jeanthom/Otter-Iron-PRO/v2.1/Bottom/USB Type C Port (SMD Type).STEP

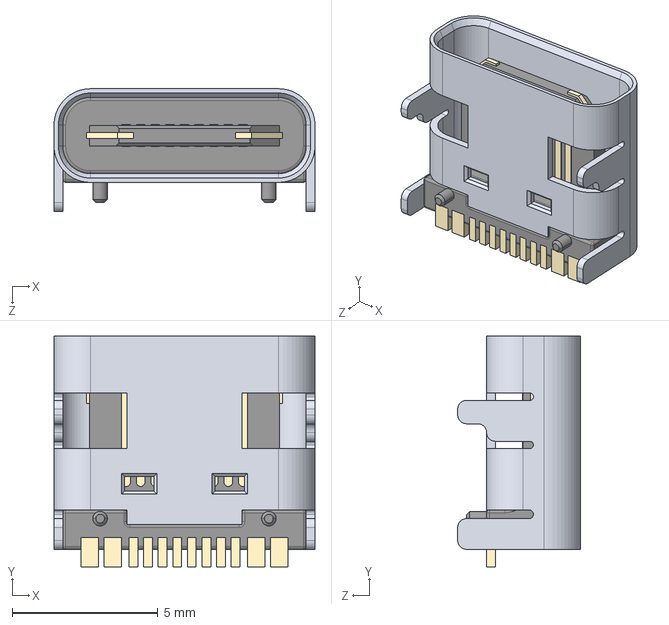
[picture p1: CAD file, 2025-04-08]
v2.1/Bottom/USB Type C Port (SMD Type).STEP
8.94 x 7.90 x 4.20 mm
