jeanthom/Otter-Iron-PRO/v2.1/C245/RPC1-12RB-6P.stp

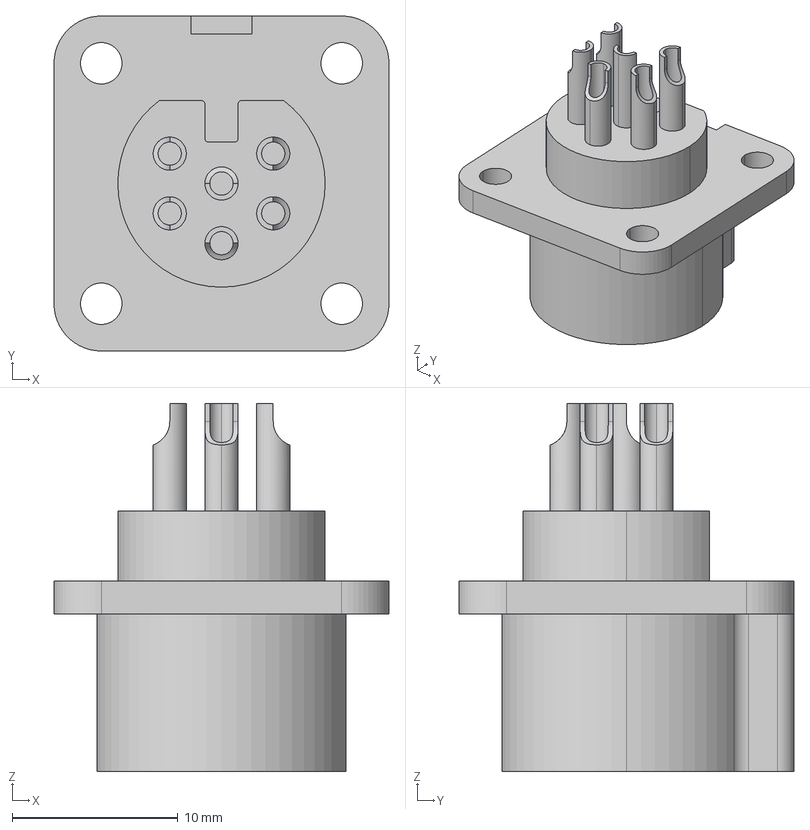
[picture p2: CAD file, 2025-04-08]
v2.1/C245/RPC1-12RB-6P.stp
20.2 x 20.2 x 22.2 mm
