jeanthom/Otter-Iron-PRO/v2.1/Stackup.FCStd

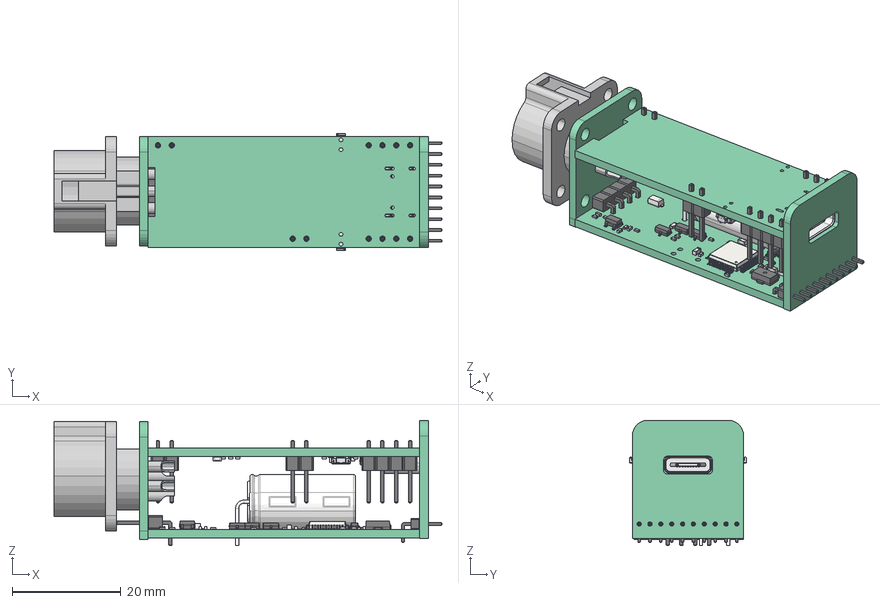
[picture p3: CAD file, 2025-04-08]
v2.1/Stackup.FCStd
71.4 x 21.6 x 23.1 mm
Pcb_2461
J6_PinHeader_1x04_P254mm_Vertical_5E93BB02
J5_PinHeader_1x04_P254mm_Vertical_5E93BAEA
J4_PinHeader_1x02_P254mm_Vertical_5E93BAD2
J3_PinHeader_1x02_P254mm_Vertical_5E93BABC
R10_R_0603_1608Metric_5E93AD9D
R24_R_0603_1608Metric_5E93ADFF
R23_R_0603_1608Metric_5E93ADF8
R13_R_0603_1608Metric_5E93ADB2
R11_R_0603_1608Metric_5E93ADA4
R7_R_0603_1608Metric_5E93AD88
C21_C_0603_1608Metric_5E93BA3C
C20_C_0603_1608Metric_5E93ABF7
C19_C_0603_1608Metric_5E93ABF0
C15_C_0603_1608Metric_5E93ABD4
C14_C_0603_1608Metric_5E93ABCD
C13_C_0603_1608Metric_5E93ABC6
C12_C_0603_1608Metric_5E93ABBF
U3_QFN_24_1EP_4x4mm_P05mm_EP27x27mm_5E93AEA4
U1_SOT_23_6_5E93AE5A
SW2_User Library-EVQP7-JA-01P_5E93AE44
SW1_User Library-EVQP7-JA-01P_5E93AE25
J1_USB Type C Port (SMD Type)_5E93AC6F
Pcb_9526
J1_PinHeader_1x10_P200mm_Horizontal_5E95C6C6
U4_LQFP_48_7x7mm_P05mm_5E93AEFF
J3_PinHeader_1x04_P254mm_Horizontal_5E93ACCE
U7_SOT_23_5_5E93AF3E
U6_SOT_23_5E93AF29
U5_SOT_23_5_5E93AF14
U2_SOT_89_3_5E93AE72
R25_R_0402_1005Metric_5E93AE06
R22_R_0805_2012Metric_5E93ADF1
R21_R_0402_1005Metric_5E93ADEA
R20_R_0402_1005Metric_5E93ADE3
R19_R_0603_1608Metric_5E93ADDC
R18_R_0402_1005Metric_5E93ADD5
R17_R_0402_1005Metric_5E93ADCE
R16_R_0402_1005Metric_5E93ADC7
R15_R_0402_1005Metric_5E93ADC0
R14_R_0402_1005Metric_5E93ADB9
R12_R_0402_1005Metric_5E93ADAB
R9_R_0402_1005Metric_5E93AD96
R8_R_0402_1005Metric_5E93AD8F
R6_R_0402_1005Metric_5E93AD81
R5_R_0402_1005Metric_5E93AD7A
R2_R_0402_1005Metric_5E93AD65
R1_R_0402_1005Metric_5E93AD5E
Q4_SOT_23_5E93AD57
Q3_SOT_23_5E93AD42
Q1_SOT_23_5E93AD14
D3_D_SOD_123F_5E93AC4E
C24_capacitor_bertical_mount_5E93AC35
C22_C_0402_1005Metric_5E93AC05
C18_C_0402_1005Metric_5E93ABE9
C17_C_0402_1005Metric_5E93ABE2
C16_C_0402_1005Metric_5E93ABDB
C11_C_0603_1608Metric_5E93ABB8
C10_C_0402_1005Metric_5E93ABB1
C9_C_0603_1608Metric_5E93ABAA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
