jeanthom/Otter-Iron-PRO/v2.1/Bottom/User Library-EVQP7-JA-01P.step

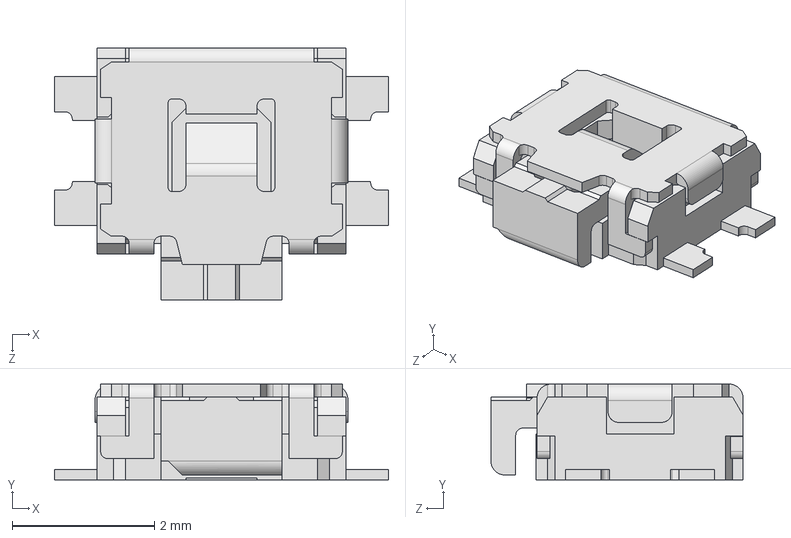
[picture p4: CAD file, 2025-04-08]
v2.1/Bottom/User Library-EVQP7-JA-01P.step
4.70 x 1.35 x 3.55 mm
