jeanthom/Otter-Iron-PRO/v2.1/Bottom/cap_el_horizontal_d10_h20_p5_w0.6.stp

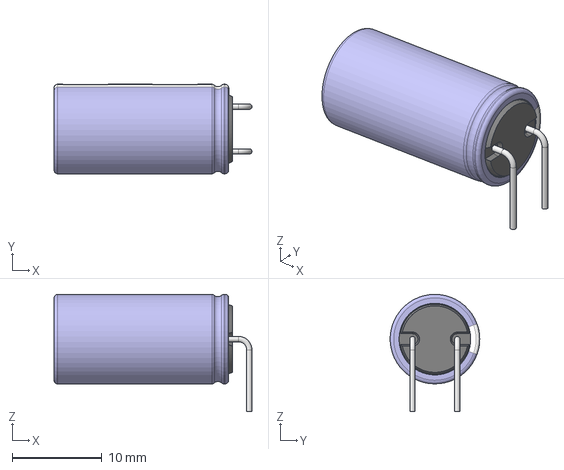
[picture p5: CAD file, 2025-04-08]
v2.1/Bottom/cap_el_horizontal_d10_h20_p5_w0.6.stp
22.1 x 10.0 x 13.1 mm
