jeanthom/Otter-Iron-PRO/v2.1/Bottom/vls6045ex.step

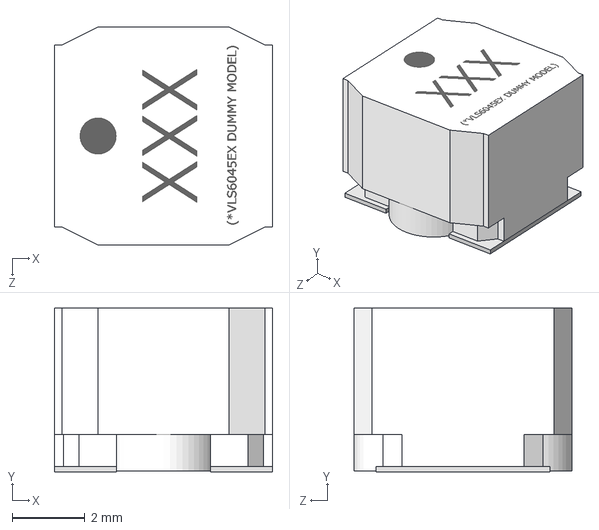
[picture p6: CAD file, 2025-04-08]
v2.1/Bottom/vls6045ex.step
6.00 x 4.50 x 6.00 mm
VLS6045EX_C(3Dmodel)
VLS6045EX_T(3Dmodel)
