jeanthom/Otter-Iron-PRO/v2.1/Bottom/Diodes_-_DMP3017SFG-7.step

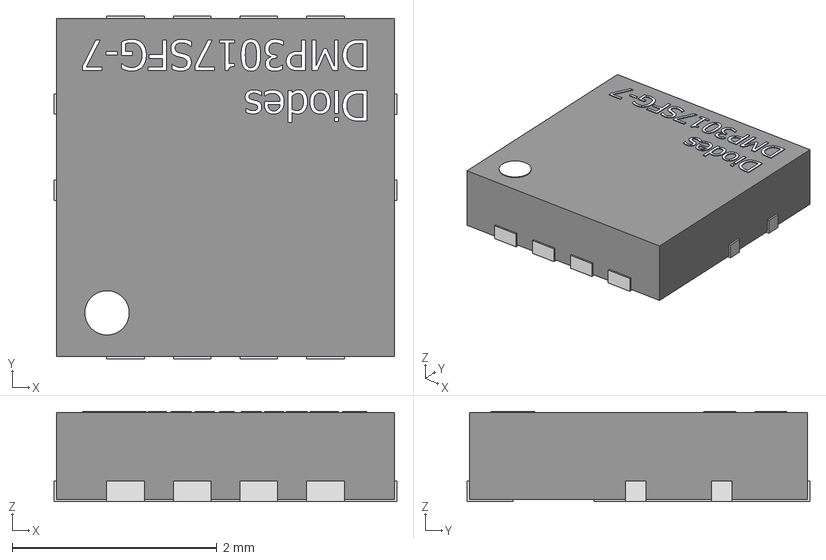
[picture p7: CAD file, 2025-04-08]
v2.1/Bottom/Diodes_-_DMP3017SFG-7.step
3.35 x 3.35 x 0.88 mm
