jeanthom/Otter-Iron-PRO/v2.1/Top/OtterIron_PRO_Top.kicad_pcb

## KiCad design v2.1/Top/OtterIron_PRO_Top.kicad_pcb (2025-04-08)

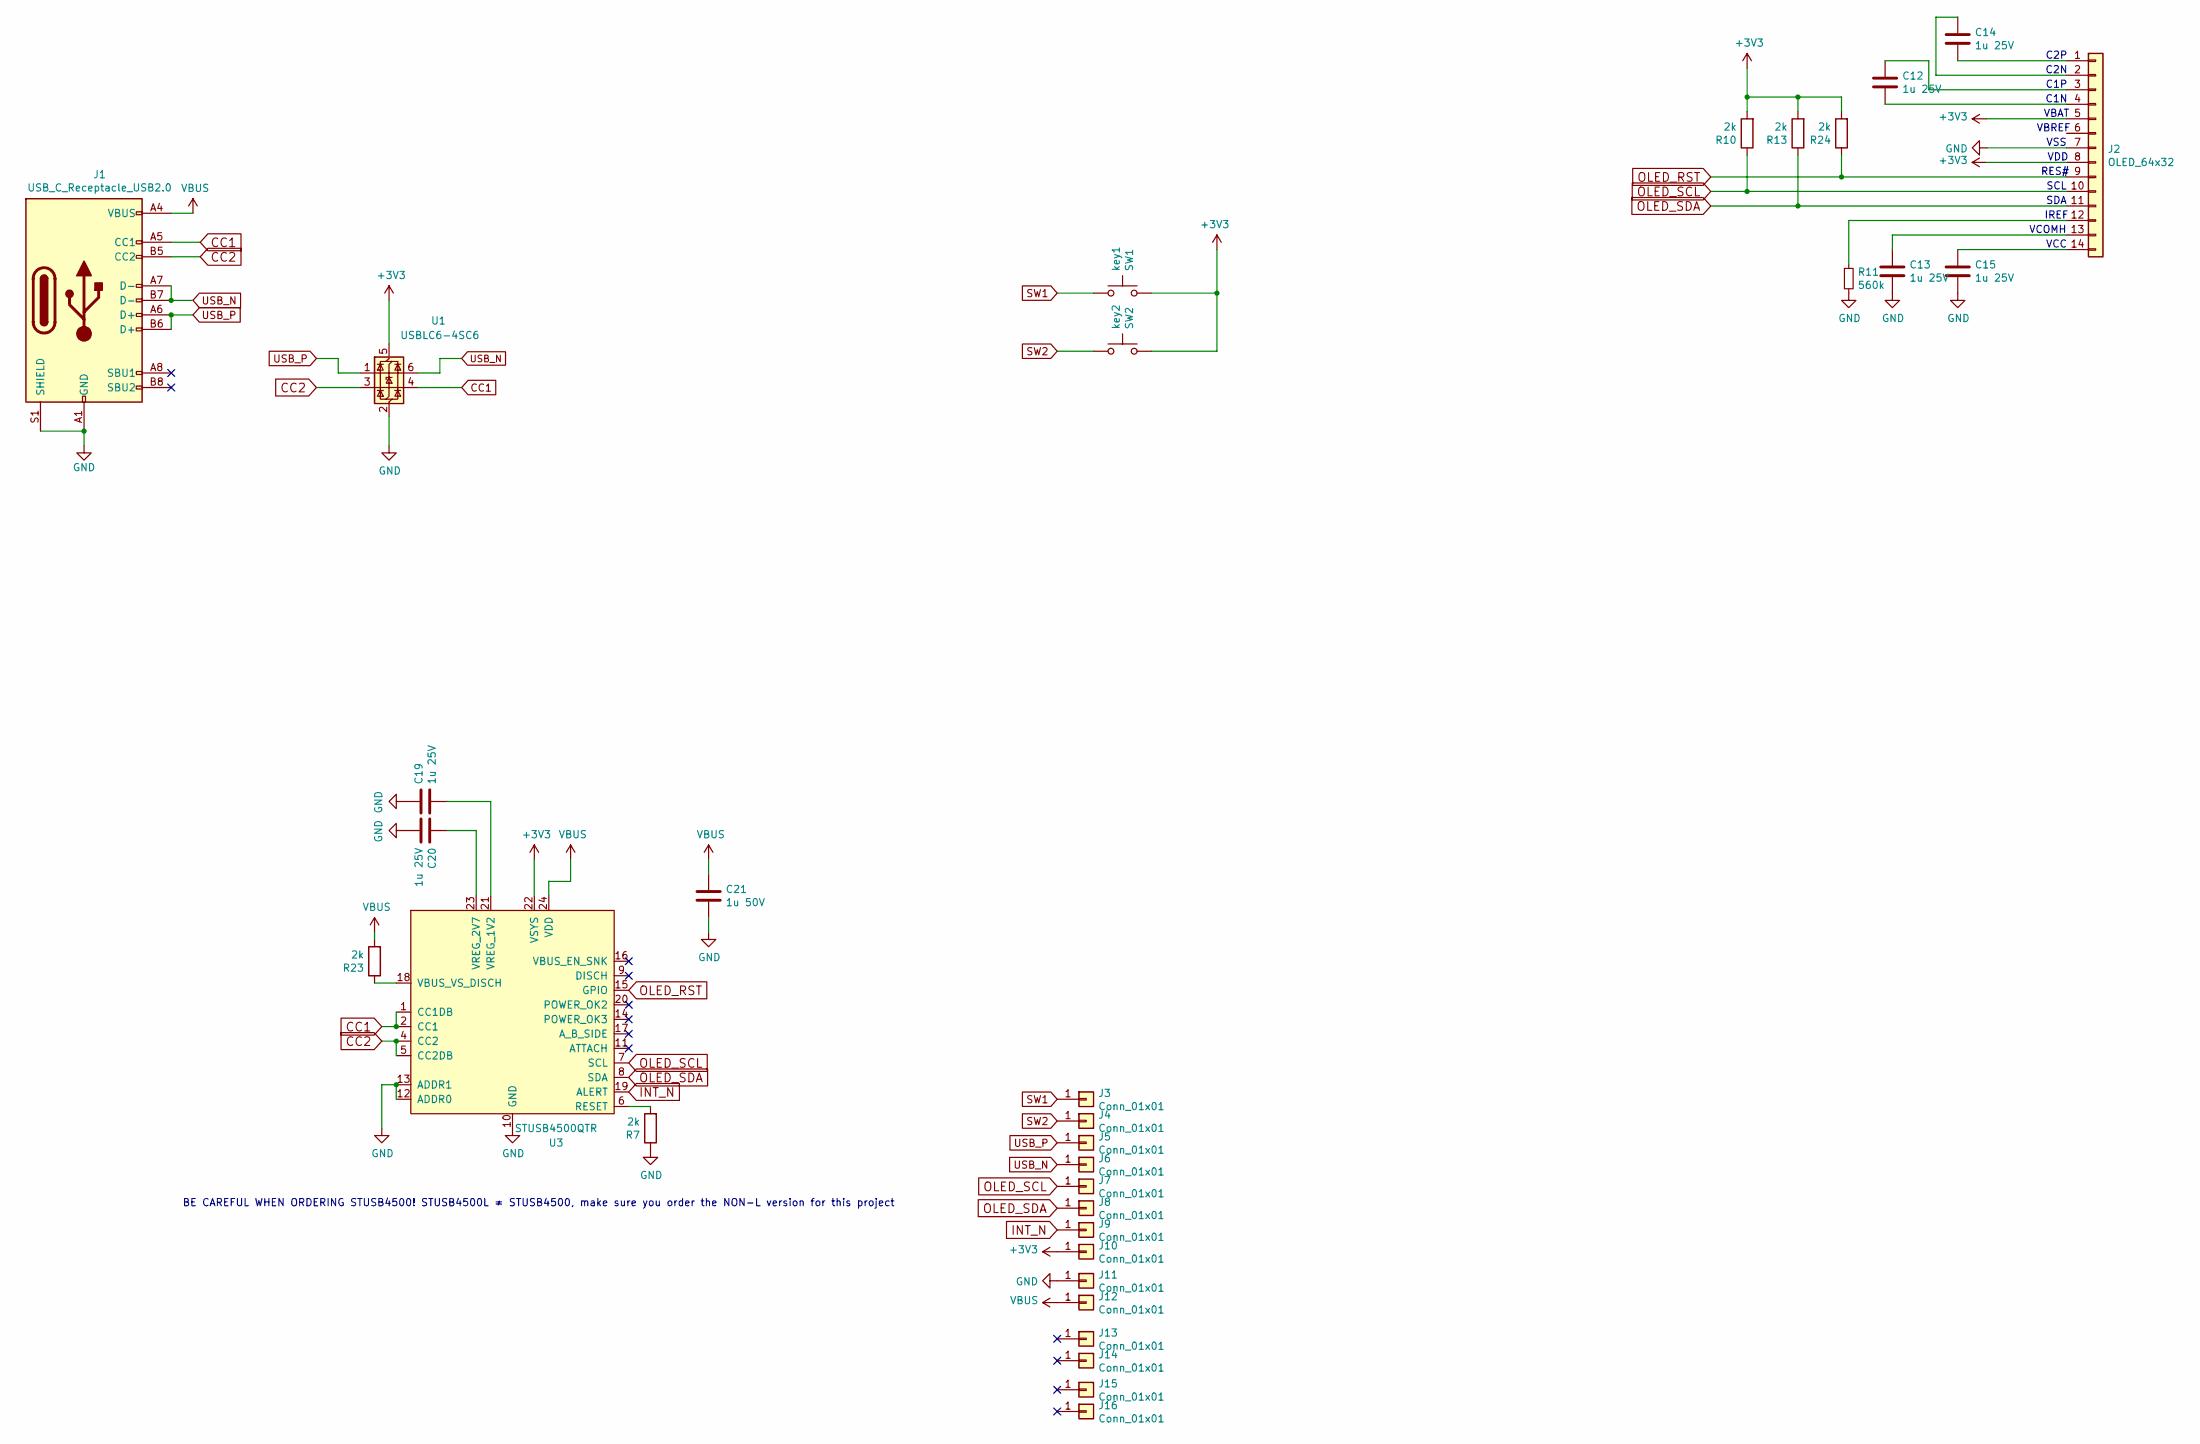
[picture p8: schematic OtterIron_PRO_Top.kicad_sch]

Parts:
C12, C13, C14, C15, C19, C20: 1u 25V; C_0603; LCSC C15849
C21: 1u 50V; C_0603; LCSC C15849
J1: USB_C_Receptacle_USB2.0; USB-C 16Pin; LCSC C167321
J2: OLED_64x32; 0.69OLED
J3, J4, J7, J8, J9, J10: Conn_01x01; pad_1_2
J5, J6: Conn_01x01; pad_0.75_3
J11, J12, J13, J14, J15, J16: Conn_01x01; pad_1.5_3
R7, R10, R13, R23, R24: 2k; R_0603; LCSC C4109
R11: 560k; R_0603; LCSC C23203
SW1: key1; SW_SPST_EVQP7C; LCSC C388883
SW2: key2; SW_SPST_EVQP7C; LCSC C388883
U1: USBLC6-4SC6; SOT-23-6; LCSC C7519
U3: STUSB4500QTR; QFN-24-1EP_4x4mm_P0.5mm_EP2.7x2.7mm; LCSC C2678061

Connections:
+3V3: J2.5, J2.8, J10.1, R10.2, R13.2, R24.2, SW1.1, SW2.1, U1.5 (VBUS), U3.22 (VSYS)
CC1: J1.A5 (CC1), U1.4 (I/O2), U3.1 (CC1DB), U3.2 (CC1)
CC2: J1.B5 (CC2), U1.3 (I/O2), U3.4 (CC2), U3.5 (CC2DB)
GND: C13.2, C15.2, C19.1, C20.2, C21.2, J1.A1 (GND), J1.A12 (GND), J1.B1 (GND), J1.B12 (GND), J1.S1 (SHIELD), J2.7, J11.1, R7.1, R11.2, U1.2 (GND), U3.10 (GND), U3.12 (ADDR0), U3.13 (ADDR1), U3.25 (GND)
INT_N: J9.1, U3.19 (ALERT)
unnamed: C14.2, J2.1
unnamed: C14.1, J2.2
unnamed: C12.1, J2.3
unnamed: C12.2, J2.4
unnamed: J2.12, R11.1
unnamed: C13.1, J2.13
unnamed: C15.1, J2.14
unnamed: R7.2, U3.6 (RESET)
unnamed: R23.1, U3.18 (VBUS_VS_DISCH)
unnamed: C19.2, U3.21 (VREG_1V2)
unnamed: C20.1, U3.23 (VREG_2V7)
OLED_RST: J2.9, R24.1, U3.15 (GPIO)
OLED_SCL: J2.10, J7.1, R10.1, U3.7 (SCL)
OLED_SDA: J2.11, J8.1, R13.1, U3.8 (SDA)
SW1: J3.1, SW1.2
SW2: J4.1, SW2.2
USB_N: J1.A7 (D-), J1.B7 (D-), J6.1, U1.6 (I/O1)
USB_P: J1.A6 (D+), J1.B6 (D+), J5.1, U1.1 (I/O1)
VBUS: C21.1, J1.A4 (VBUS), J1.A9 (VBUS), J1.B4 (VBUS), J1.B9 (VBUS), J12.1, R23.2, U3.24 (VDD)

Notes on the sheet:
VBAT
SCL
RES#
IREF
SDA
VBREF
C2P
C1P
VCC
C1N
C2N
BE CAREFUL WHEN ORDERING STUSB4500! STUSB4500L ≠ STUSB4500, make sure you order the NON-L version for this project
VCOMH
VSS
VDD

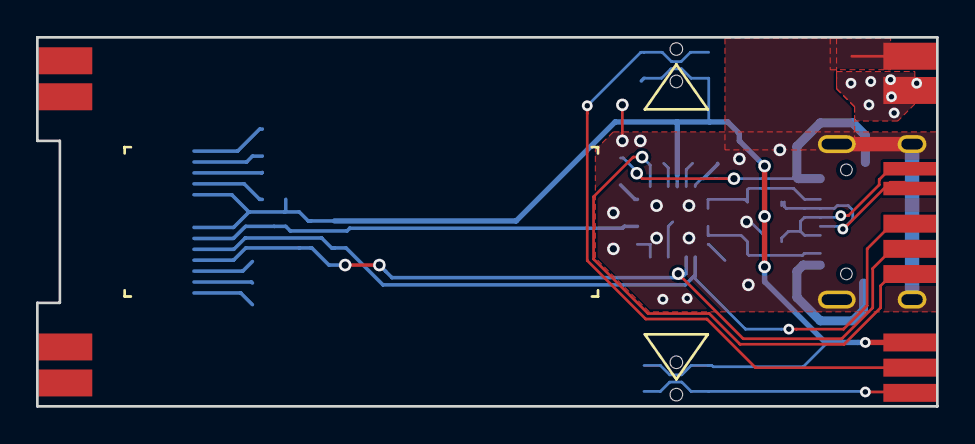
[picture p9: board OtterIron_PRO_Top.kicad_pcb from above]

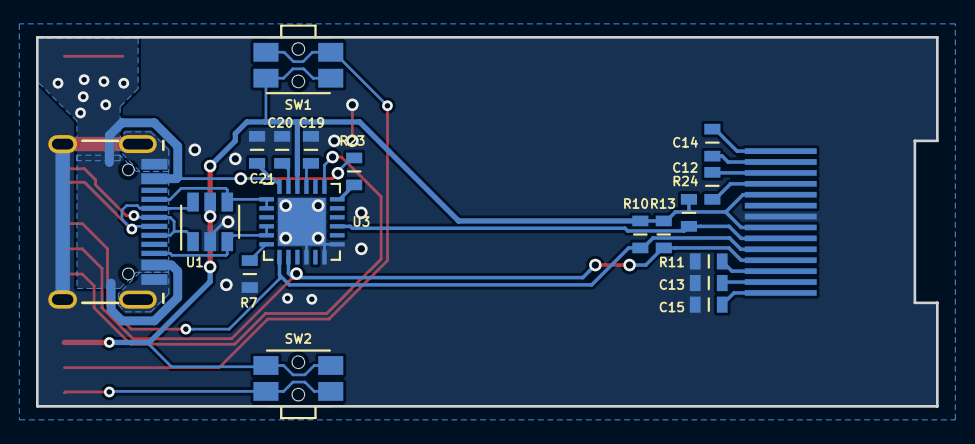
[picture p10: board OtterIron_PRO_Top.kicad_pcb from below]

Board: 2 copper layers, 50.0 x 20.5 mm, 33 parts (19 on the bottom side), 24 nets.
