jeanthom/Otter-Iron-PRO/v2.1/Bottom/OtterIron_PRO_Bot.kicad_pcb

## KiCad design v2.1/Bottom/OtterIron_PRO_Bot.kicad_pcb (2025-04-08)

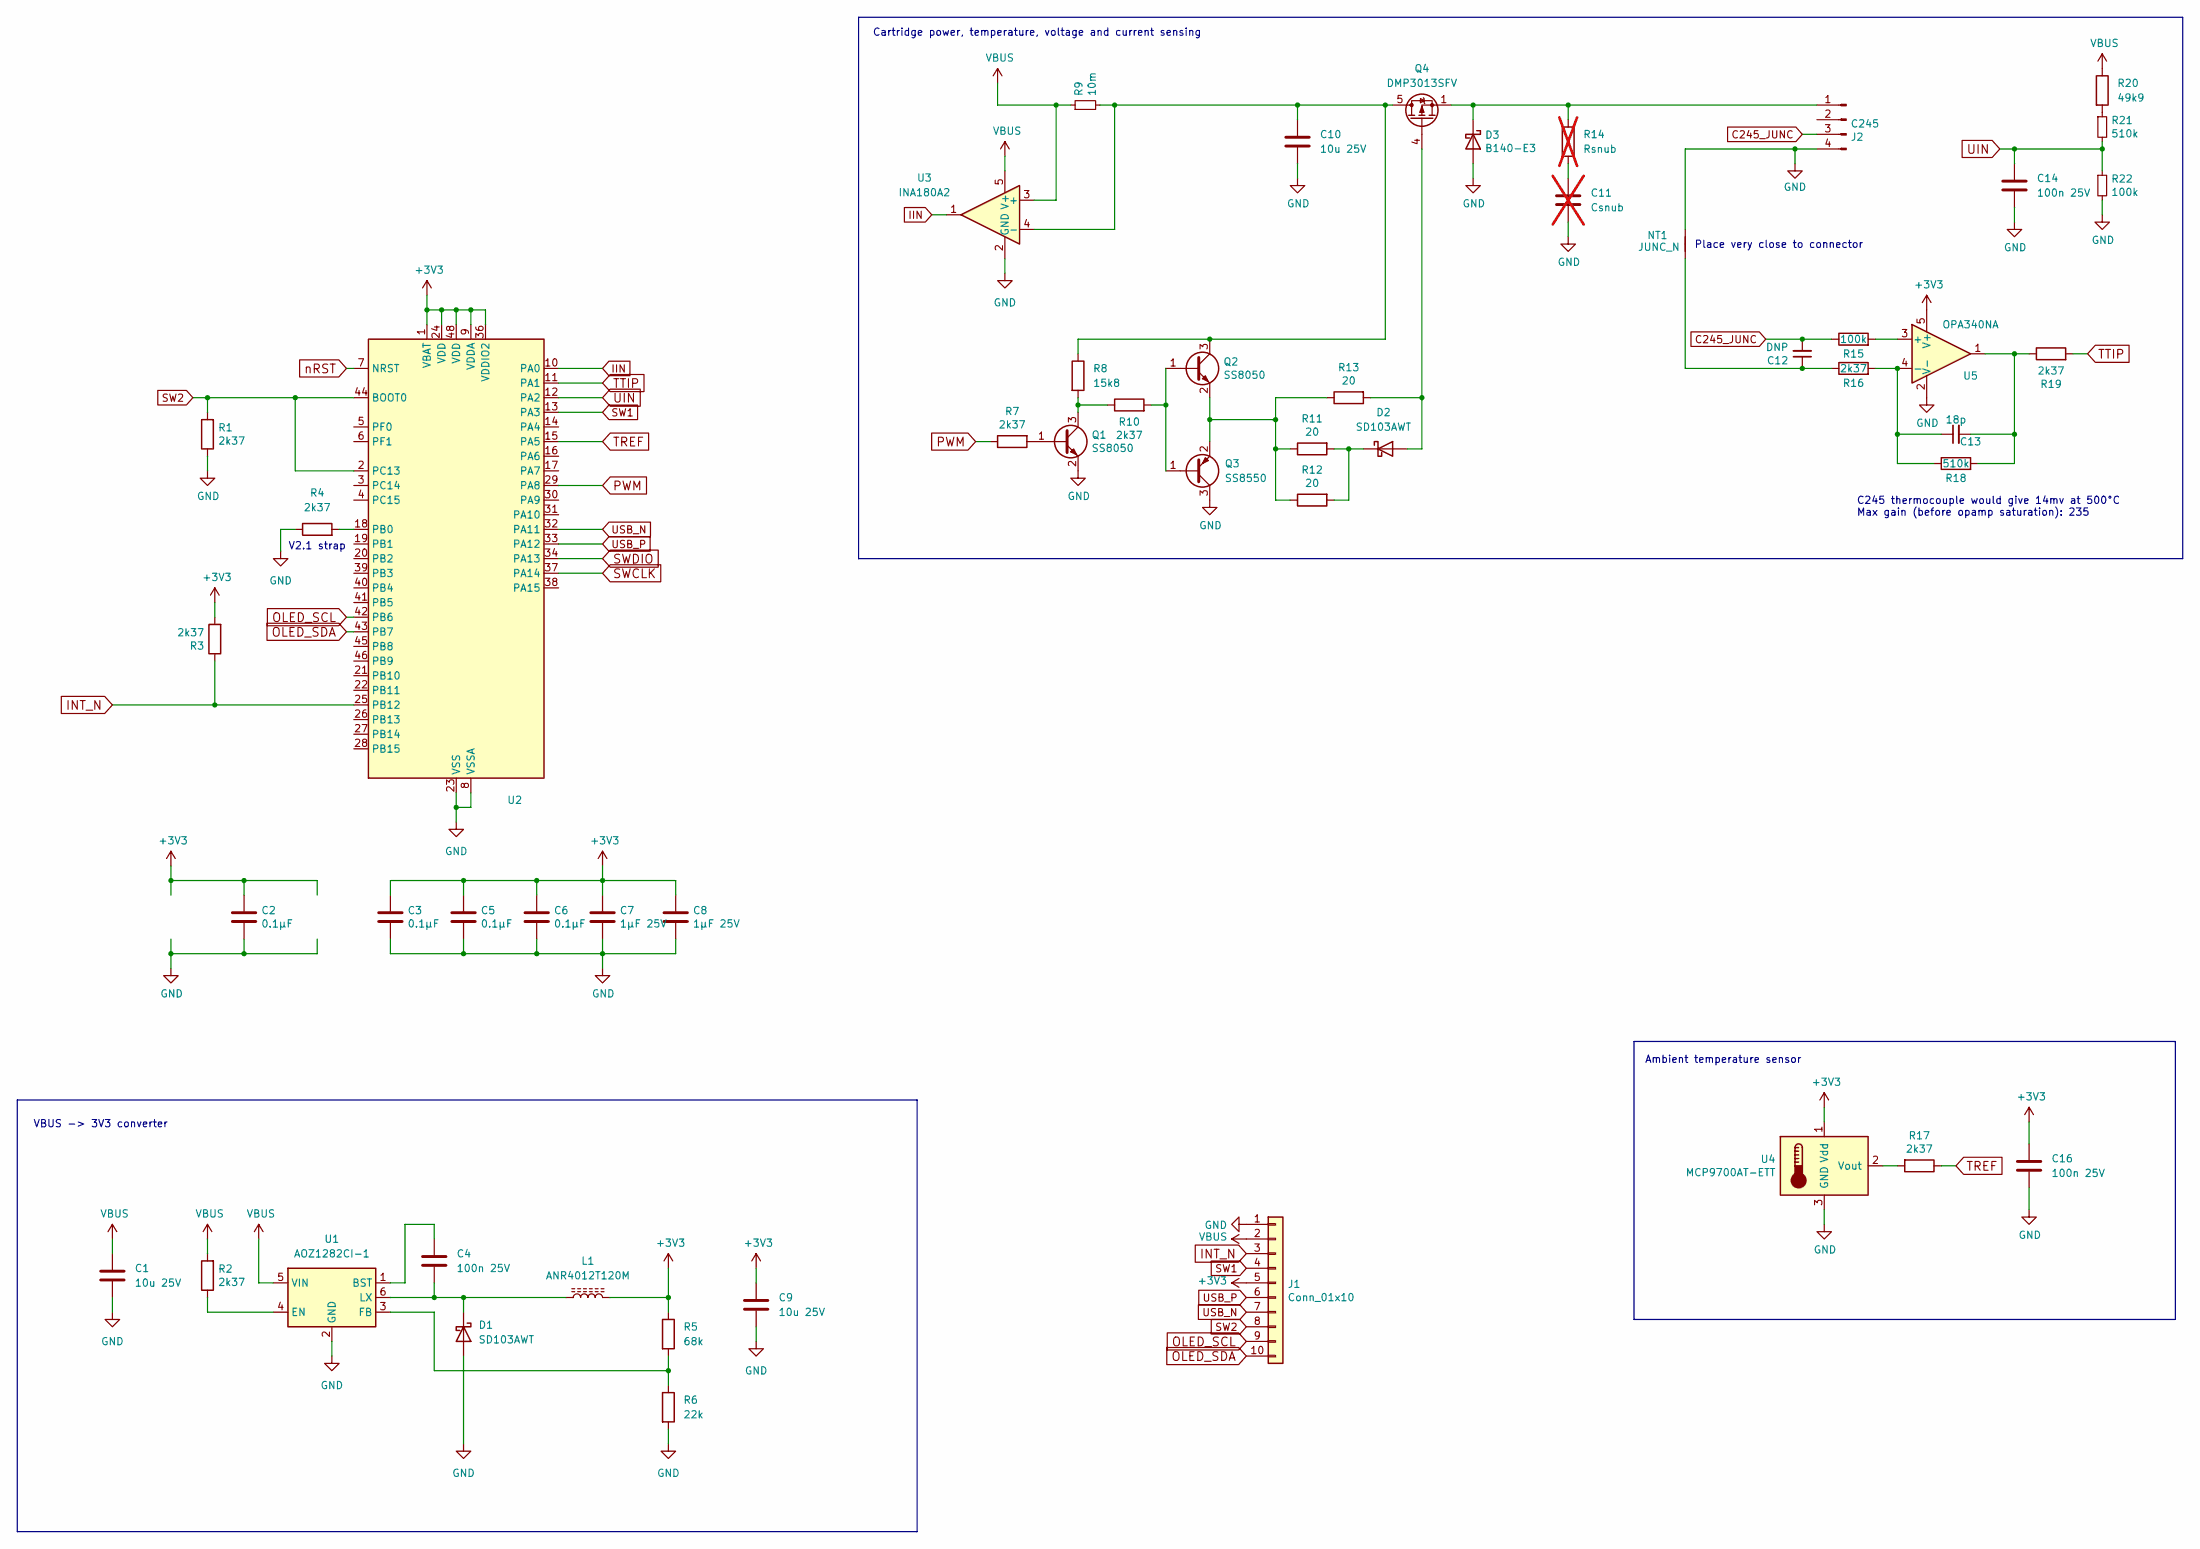
[picture p11: schematic OtterIron_PRO_Bot.kicad_sch]

Parts:
C1, C9, C10: 10u 25V; C_0603_1608Metric; LCSC C96446
C2, C3, C5, C6: 0.1μF; C_0402_1005Metric
C4, C14, C16: 100n 25V; C_0402_1005Metric; LCSC C100072
C7, C8: 1μF 25V; C_0603_1608Metric
C11: Csnub; C_0603_1608Metric; not fitted
C12: DNP; C_0402_1005Metric
C13: 18p; C_0402_1005Metric
D1, D2: SD103AWT; D_SOD-523; LCSC C22466357
D3: B140-E3; D_SOD-123F
J1: Conn_01x10; PinHeader_1x10_P2.00mm_Horizontal
J2: C245; PinHeader_1x04_P2.54mm_Horizontal
L1: ANR4012T120M; L_APV_ANR4012; LCSC C6808080
NT1: JUNC_N; NetTie-2_SMD_Pad0.5mm
Q1, Q2: SS8050; SOT-23
Q3: SS8550; SOT-23
Q4: DMP3013SFV; Diodes_PowerDI3333-8; LCSC C264098
R1, R2, R3, R4, R7, R10, R16, R17, R19: 2k37; R_0402_1005Metric
R5: 68k; R_0402_1005Metric; LCSC C137969
R6: 22k; R_0402_1005Metric; LCSC C852544
R8: 15k8; R_0402_1005Metric; LCSC C852544
R9: 10m; R_0805_2012Metric; LCSC C270927
R11, R12, R13: 20; R_0402_1005Metric
R14: Rsnub; R_0402_1005Metric; not fitted
R15, R22: 100k; R_0402_1005Metric
R18, R21: 510k; R_0402_1005Metric; LCSC C11616
R20: 49k9; R_0402_1005Metric; LCSC C137969
U1: AOZ1282CI-1; SOT-23-6; LCSC C2070766
U2: STM32F072C8Tx; LQFP-48_7x7mm_P0.5mm
U3: INA180A2; SOT-23-5
U4: MCP9700AT-ETT; SOT-23
U5: OPA340NA; SOT-23-5

Connections:
+3V3: C2.1, C3.1, C5.1, C6.1, C7.1, C8.1, C9.1, C16.1, J1.5, L1.2, R3.2, R5.1, U2.1 (VBAT), U2.9 (VDDA), U2.24 (VDD), U2.36 (VDDIO2), U2.48 (VDD), U4.1 (Vdd), U5.5 (V+)
C245_JUNC: C12.2, J2.3, R15.1
GND: C1.2, C2.2, C3.2, C5.2, C6.2, C7.2, C8.2, C9.2, C10.2, C11.2, C14.2, C16.2, D1.2 (A), D3.2 (A), J1.1, J2.4, NT1.2, Q1.2 (E), Q3.3 (C), R1.1, R4.1, R6.2, R22.2, U1.2 (GND), U2.8 (VSSA), U2.23 (VSS), U2.35 (VSS), U2.47 (VSS), U3.2 (GND), U4.3 (GND), U5.2 (V-)
IIN: U2.10 (PA0), U3.1
INT_N: J1.3, R3.1, U2.25 (PB12)
unnamed: C11.1, R14.2
unnamed: C12.1, NT1.1, R16.1
unnamed: C13.2, R18.2, R19.1, U5.1
unnamed: C4.2, D1.1 (K), L1.1, U1.6 (LX)
unnamed: D2.2 (A), Q4.4 (G), R13.2
unnamed: D2.1 (K), R11.2, R12.2
unnamed: D3.1 (K), J2.1, Q4.1 (S), Q4.2 (S), Q4.3 (S), R14.1
unnamed: Q1.1 (B), R7.2
unnamed: Q1.3 (C), R8.2, R10.1
unnamed: Q2.1 (B), Q3.1 (B), R10.2
unnamed: C10.1, Q2.3 (C), Q4.5 (D), R8.1, R9.2, U3.4 (-)
unnamed: Q2.2 (E), Q3.2 (E), R11.1, R12.1, R13.1
unnamed: R20.2, R21.1
unnamed: C4.1, U1.1 (BST)
unnamed: R2.1, U1.4 (EN)
unnamed: R5.2, R6.1, U1.3 (FB)
unnamed: R4.2, U2.18 (PB0)
unnamed: R17.2, U4.2 (Vout)
unnamed: R15.2, U5.3 (+)
unnamed: C13.1, R16.2, R18.1, U5.4 (-)
OLED_SCL: J1.9, U2.42 (PB6)
OLED_SDA: J1.10, U2.43 (PB7)
PWM: R7.1, U2.29 (PA8)
SW1: J1.4, U2.13 (PA3)
SW2: J1.8, R1.2, U2.2 (PC13), U2.44 (BOOT0)
SWCLK: U2.37 (PA14)
SWDIO: U2.34 (PA13)
TREF: R17.1, U2.15 (PA5)
TTIP: R19.2, U2.11 (PA1)
UIN: C14.1, R21.2, R22.1, U2.12 (PA2)
USB_N: J1.7, U2.32 (PA11)
USB_P: J1.6, U2.33 (PA12)
VBUS: C1.1, J1.2, R2.2, R9.1, R20.1, U1.5 (VIN), U3.3 (+), U3.5 (V+)
nRST: U2.7 (NRST)

Notes on the sheet:
Place very close to connector
Cartridge power, temperature, voltage and current sensing
V2.1 strap
VBUS -> 3V3 converter
Ambient temperature sensor
C245 thermocouple would give 14mv at 500°C Max gain (before opamp saturation): 235

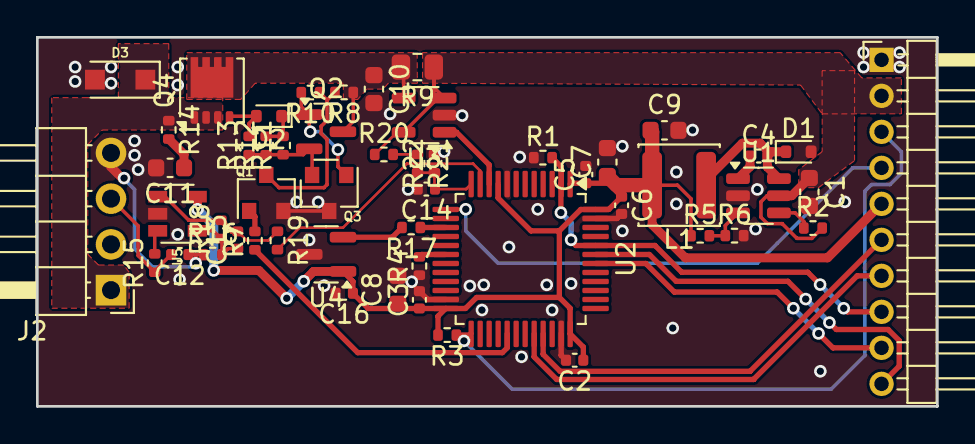
[picture p12: board OtterIron_PRO_Bot.kicad_pcb from above]

Board: 2 copper layers, 50.0 x 20.5 mm, 53 parts (0 on the bottom side), 36 nets.
