jeanthom/Otter-Iron-PRO/v2.1/USB/USB_conn.kicad_pcb

## KiCad design v2.1/USB/USB_conn.kicad_pcb (2025-04-08)

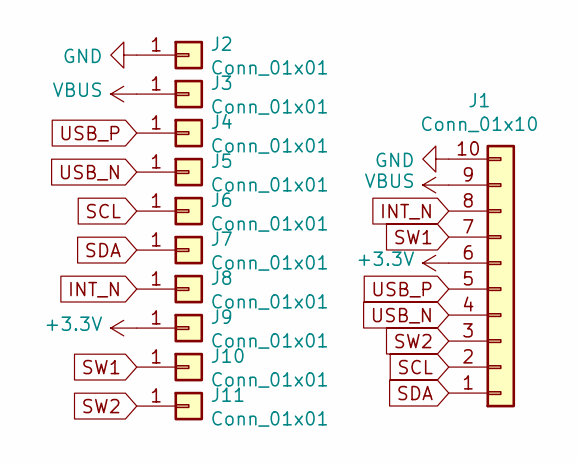
[picture p13: schematic USB_conn.sch]

Parts:
J1: Conn_01x10; PinHeader_1x10_P2.00mm_Vertical
J2, J3: Conn_01x01; pad_1.5_3
J4, J5: Conn_01x01; pad_0.75_3
J6, J7, J8, J9, J10, J11: Conn_01x01; pad_1_2

Connections:
+3V3: J1.6, J9.1
GND: J1.10, J2.1
INT_N: J1.8, J8.1
SCL: J1.2, J6.1
SDA: J1.1, J7.1
SW1: J1.7, J10.1
SW2: J1.3, J11.1
USB_N: J1.4, J5.1
USB_P: J1.5, J4.1
VBUS: J1.9, J3.1

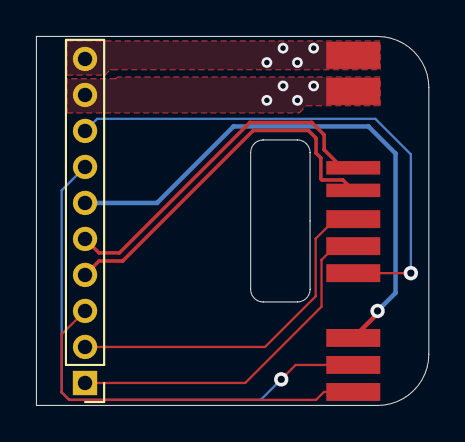
[picture p14: board USB_conn.kicad_pcb from above]

Board: 2 copper layers, 21.8 x 20.5 mm, 11 parts (0 on the bottom side), 10 nets.
